RoboFEI/Eletronics/Communication_Board/Communication_Board/Communication_Board.kicad_pcb

## KiCad design Communication_Board/Communication_Board/Communication_Board.kicad_pcb (2024-09-18)

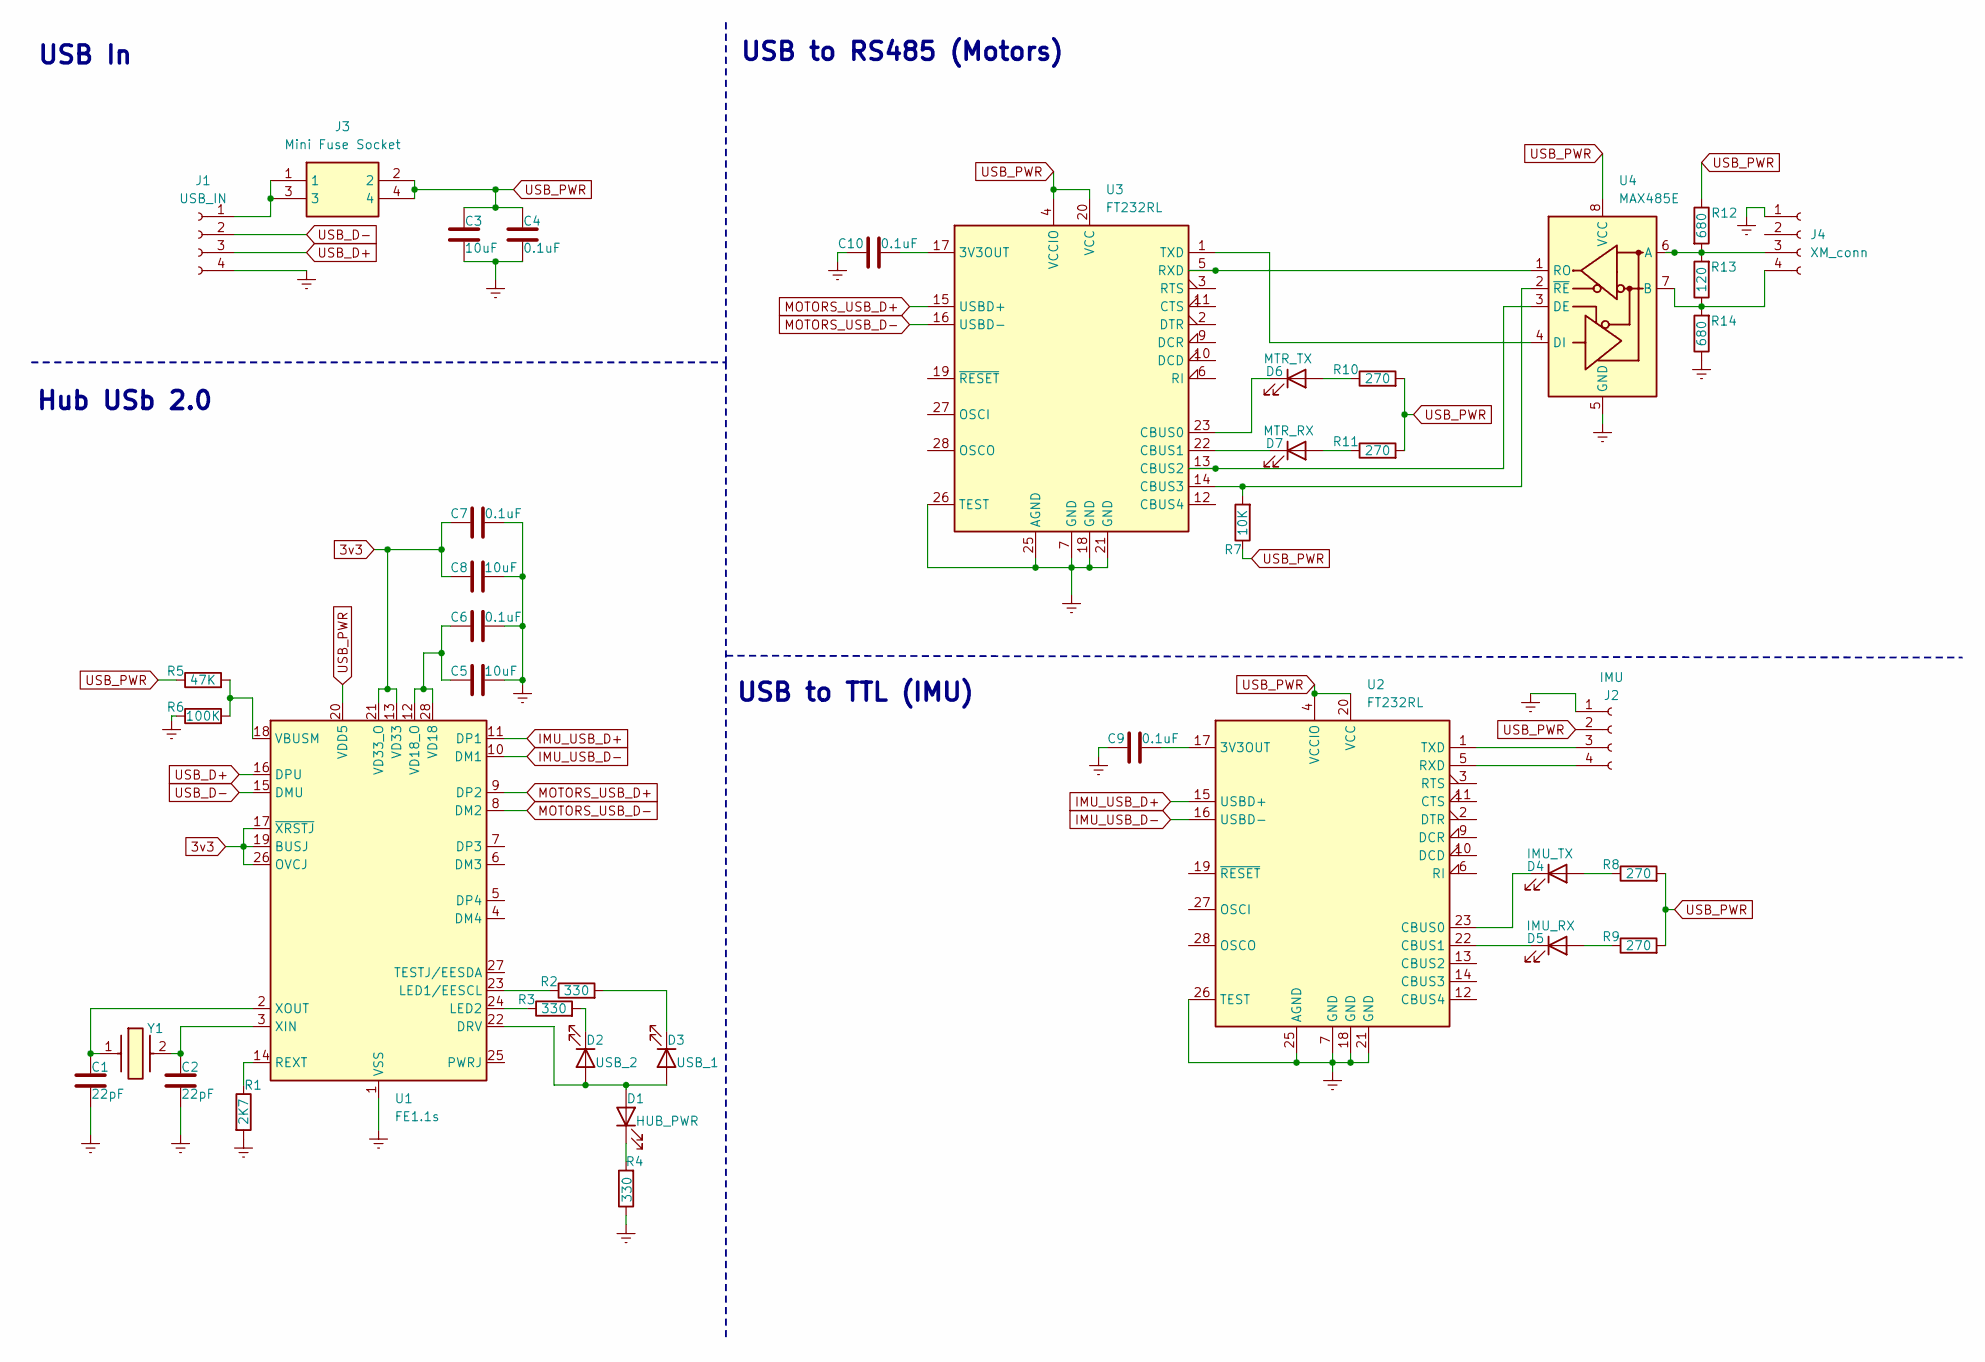
[picture p1: schematic Communication_Board.kicad_sch, Communication Board for Humanoid Robot]

Parts:
C1, C2: 22pF; C_1206_3216Metric
C3, C5, C8: 10uF; C_1206_3216Metric
C4, C6, C7, C9, C10: 0.1uF; C_1206_3216Metric
D1: HUB_PWR; LED_1206_3216Metric_Pad1.42x1.75mm_HandSolder
D2: USB_2; LED_1206_3216Metric_Pad1.42x1.75mm_HandSolder
D3: USB_1; LED_1206_3216Metric_Pad1.42x1.75mm_HandSolder
D4: IMU_TX; LED_1206_3216Metric_Pad1.42x1.75mm_HandSolder
D5: IMU_RX; LED_1206_3216Metric_Pad1.42x1.75mm_HandSolder
D6: MTR_TX; LED_1206_3216Metric_Pad1.42x1.75mm_HandSolder
D7: MTR_RX; LED_1206_3216Metric_Pad1.42x1.75mm_HandSolder
J1: USB_IN; PinHeader_1x04_P2.54mm_Vertical
J2: IMU; PinHeader_1x04_P2.54mm_Vertical
J3: Mini Fuse Socket; Mouser Part Number 534-3557-2
J4: XM_conn; XM_conn_vertical-B4B-EH-A
R1: 2K7; R_1206_3216Metric
R2, R3, R4: 330; R_1206_3216Metric
R5: 47K; R_1206_3216Metric
R6: 100K; R_1206_3216Metric
R7: 10K; R_1206_3216Metric
R8, R9, R10, R11: 270; R_1206_3216Metric
R12, R14: 680; R_1206_3216Metric
R13: 120; R_1206_3216Metric
U1: FE1.1s; SSOP-28_3.9x9.9mm_P0.635mm
U2, U3: FT232RL; SSOP-28_5.3x10.2mm_P0.65mm
U4: MAX485E; SOIC-8_3.9x4.9mm_P1.27mm
Y1: Crystal 12MHz - ECS; Mouser Part Number 520-120-18-5PX-GM-TR

Connections:
3v3: C7.1, C8.1, U1.13 (VD33), U1.17 (~XRSTJ), U1.19 (BUSJ), U1.21 (VD33_O), U1.26 (OVCJ)
GNDREF: C1.2, C2.2, C3.2, C4.2, C5.2, C6.2, C7.2, C8.2, C9.1, C10.1, J1.4, J2.1, J4.1 (GND), R1.2, R4.1, R6.1, R14.1, U1.1 (VSS), U2.7 (GND), U2.18 (GND), U2.21 (GND), U2.25 (AGND), U2.26 (TEST), U3.7 (GND), U3.18 (GND), U3.21 (GND), U3.25 (AGND), U3.26 (TEST), U4.5 (GND)
IMU_USB_D+: U1.11 (DP1), U2.15 (USBD+)
IMU_USB_D-: U1.10 (DM1), U2.16 (USBD-)
MOTORS_USB_D+: U1.9 (DP2), U3.15 (USBD+)
MOTORS_USB_D-: U1.8 (DM2), U3.16 (USBD-)
unnamed: D1.2 (A), D2.2 (A), D3.2 (A), U1.22 (DRV)
unnamed: D1.1 (K), R4.2
unnamed: D2.1 (K), R3.2
unnamed: D3.1 (K), R2.2
unnamed: D4.2 (A), R8.1
unnamed: D4.1 (K), U2.23 (CBUS0)
unnamed: D5.2 (A), R9.1
unnamed: D5.1 (K), U2.22 (CBUS1)
unnamed: D6.2 (A), R10.1
unnamed: D6.1 (K), U3.23 (CBUS0)
unnamed: D7.2 (A), R11.1
unnamed: D7.1 (K), U3.22 (CBUS1)
unnamed: J1.1, J3.1, J3.3
unnamed: J2.3, U2.1 (TXD)
unnamed: J2.4, U2.5 (RXD)
unnamed: J4.3 (D+), R12.2, R13.2, U4.6 (A)
unnamed: J4.4 (D-), R13.1, R14.2, U4.7 (B)
unnamed: R2.1, U1.23 (LED1/EESCL)
unnamed: R3.1, U1.24 (LED2)
unnamed: R1.1, U1.14 (REXT)
unnamed: R5.2, R6.2, U1.18 (VBUSM)
unnamed: C5.1, C6.1, U1.12 (VD18_O), U1.28 (VD18)
unnamed: C2.1, U1.3 (XIN), Y1.2
unnamed: C1.1, U1.2 (XOUT), Y1.1
unnamed: C9.2, U2.17 (3V3OUT)
unnamed: C10.2, U3.17 (3V3OUT)
unnamed: U3.13 (CBUS2), U4.3 (DE)
unnamed: R7.2, U3.14 (CBUS3), U4.2 (~RE)
unnamed: U3.5 (RXD), U4.1 (RO)
unnamed: U3.1 (TXD), U4.4 (DI)
USB_D+: J1.3, U1.16 (DPU)
USB_D-: J1.2, U1.15 (DMU)
USB_PWR: C3.1, C4.1, J2.2, J3.2, J3.4, R5.1, R7.1, R8.2, R9.2, R10.2, R11.2, R12.1, U1.20 (VDD5), U2.4 (VCCIO), U2.20 (VCC), U3.4 (VCCIO), U3.20 (VCC), U4.8 (VCC)

Notes on the sheet:
USB In
USB to RS485 (Motors)
Hub USb 2.0
USB to TTL (IMU)

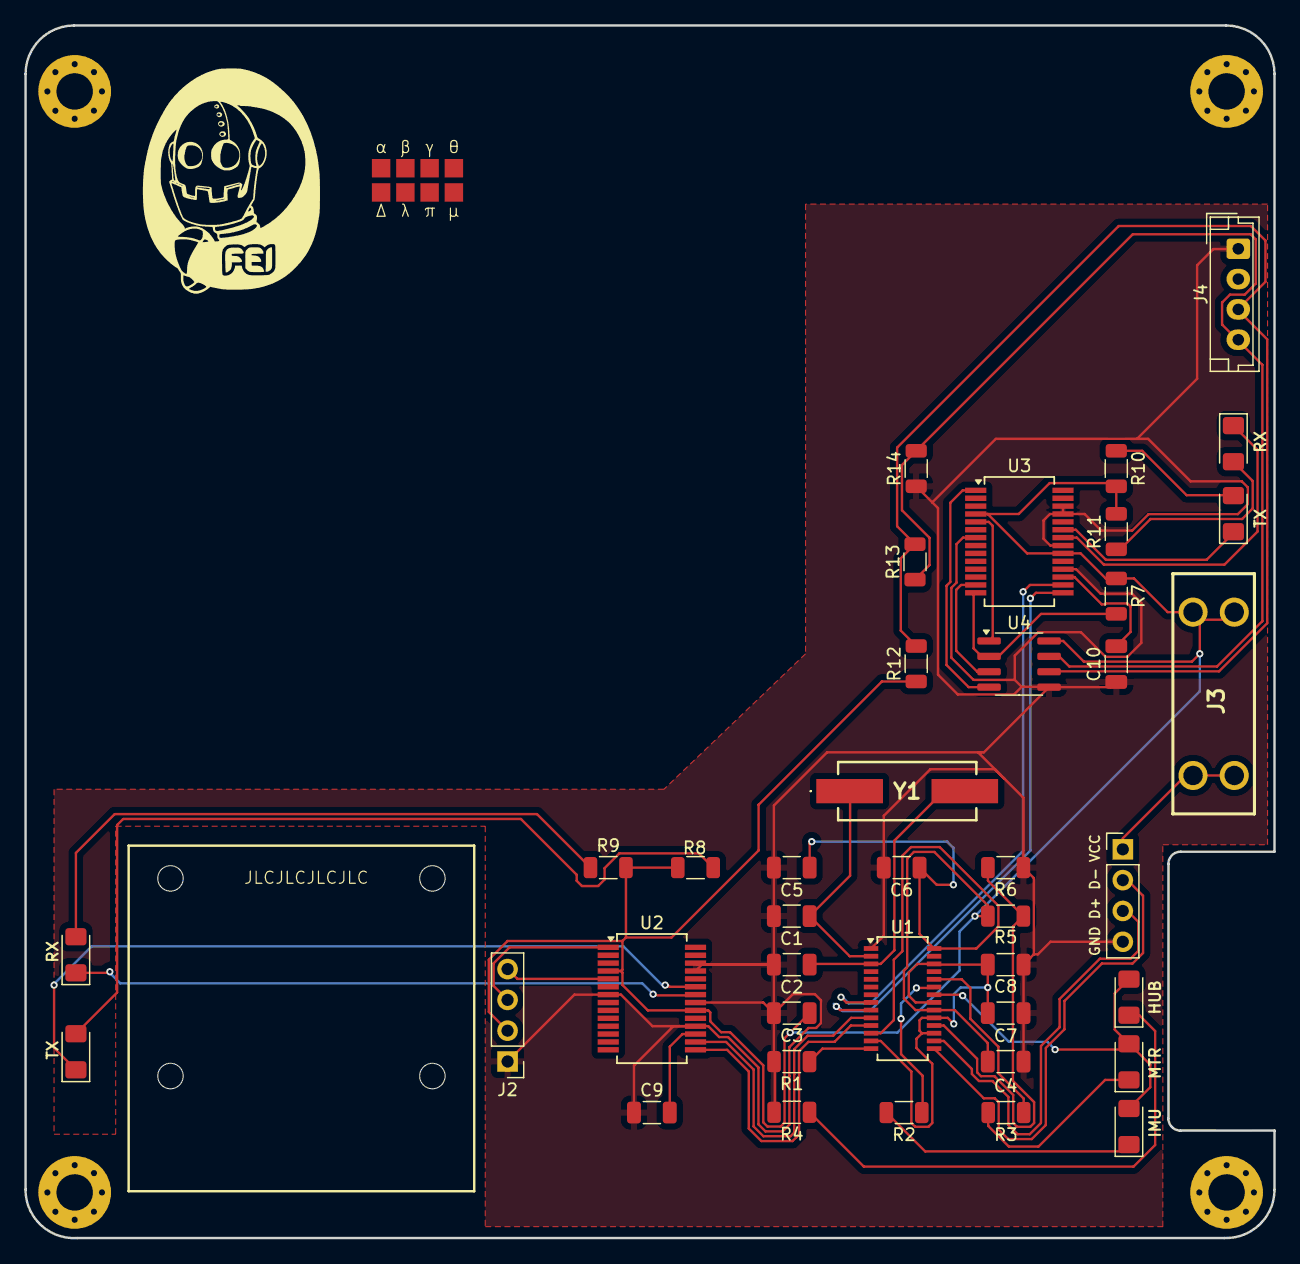
[picture p2: board Communication_Board.kicad_pcb from above]

Board: 2 copper layers, 103.0 x 100.0 mm, 40 parts (0 on the bottom side), 39 nets.
