RoboFEI/Eletronics/Power_Board/Power_Board/Power_Board.kicad_pcb

## KiCad design Power_Board/Power_Board/Power_Board.kicad_pcb (2024-09-28)

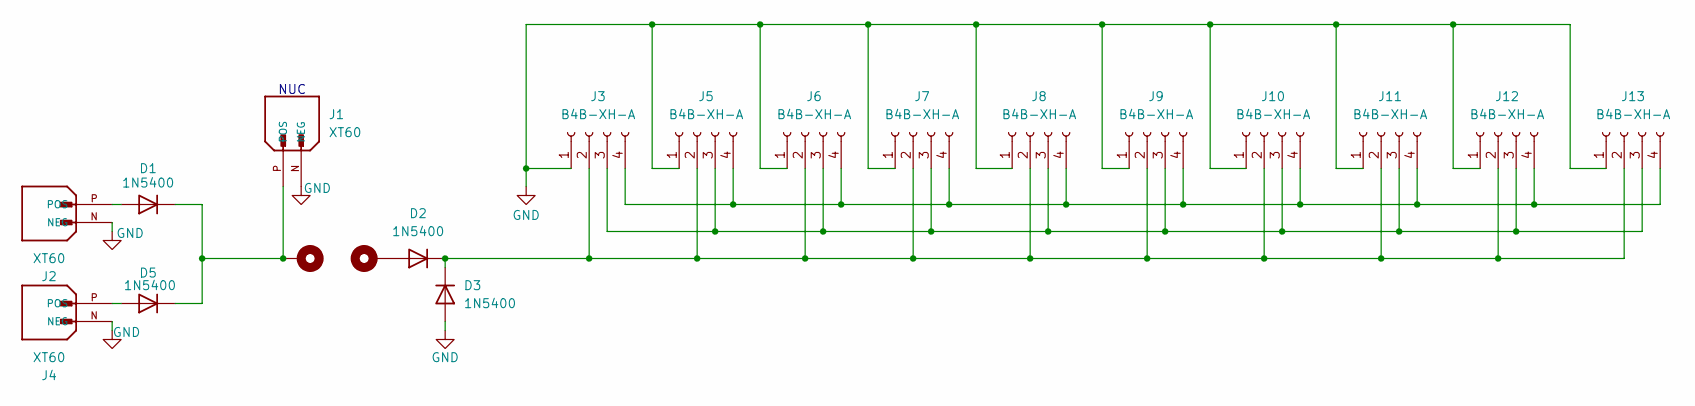
[picture p3: schematic Power_Board.kicad_sch]

Parts:
D1, D2, D3, D5: 1N5400; D_DO-201AD_P15.24mm_Horizontal
H1, H3: MountingHole_Pad; MountingHole_2.5mm_Pad
J1, J2, J4: XT60; XT60-M_Vertical; PARTREV V1.2
J3, J5, J6, J7, J8, J9, J10, J11, J12, J13: B4B-XH-A; XM_conn_vertical-B4B-EH-A; PARTREV 7/4/21

Connections:
GND: D3.2 (A), J1.N (NEG), J2.N (NEG), J3.1 (GND), J4.N (NEG), J5.1 (GND), J6.1 (GND), J7.1 (GND), J8.1 (GND), J9.1 (GND), J10.1 (GND), J11.1 (GND), J12.1 (GND), J13.1 (GND)
unnamed: D1.2 (A), J2.P (POS)
unnamed: D1.1 (K), D5.1 (K), H3.1, J1.P (POS)
unnamed: D2.2 (A), H1.1
unnamed: D2.1 (K), D3.1 (K), J3.2 (VDD), J5.2 (VDD), J6.2 (VDD), J7.2 (VDD), J8.2 (VDD), J9.2 (VDD), J10.2 (VDD), J11.2 (VDD), J12.2 (VDD), J13.2 (VDD)
unnamed: D5.2 (A), J4.P (POS)
unnamed: J3.3 (D+), J5.3 (D+), J6.3 (D+), J7.3 (D+), J8.3 (D+), J9.3 (D+), J10.3 (D+), J11.3 (D+), J12.3 (D+), J13.3 (D+)
unnamed: J3.4 (D-), J5.4 (D-), J6.4 (D-), J7.4 (D-), J8.4 (D-), J9.4 (D-), J10.4 (D-), J11.4 (D-), J12.4 (D-), J13.4 (D-)

Notes on the sheet:
NUC

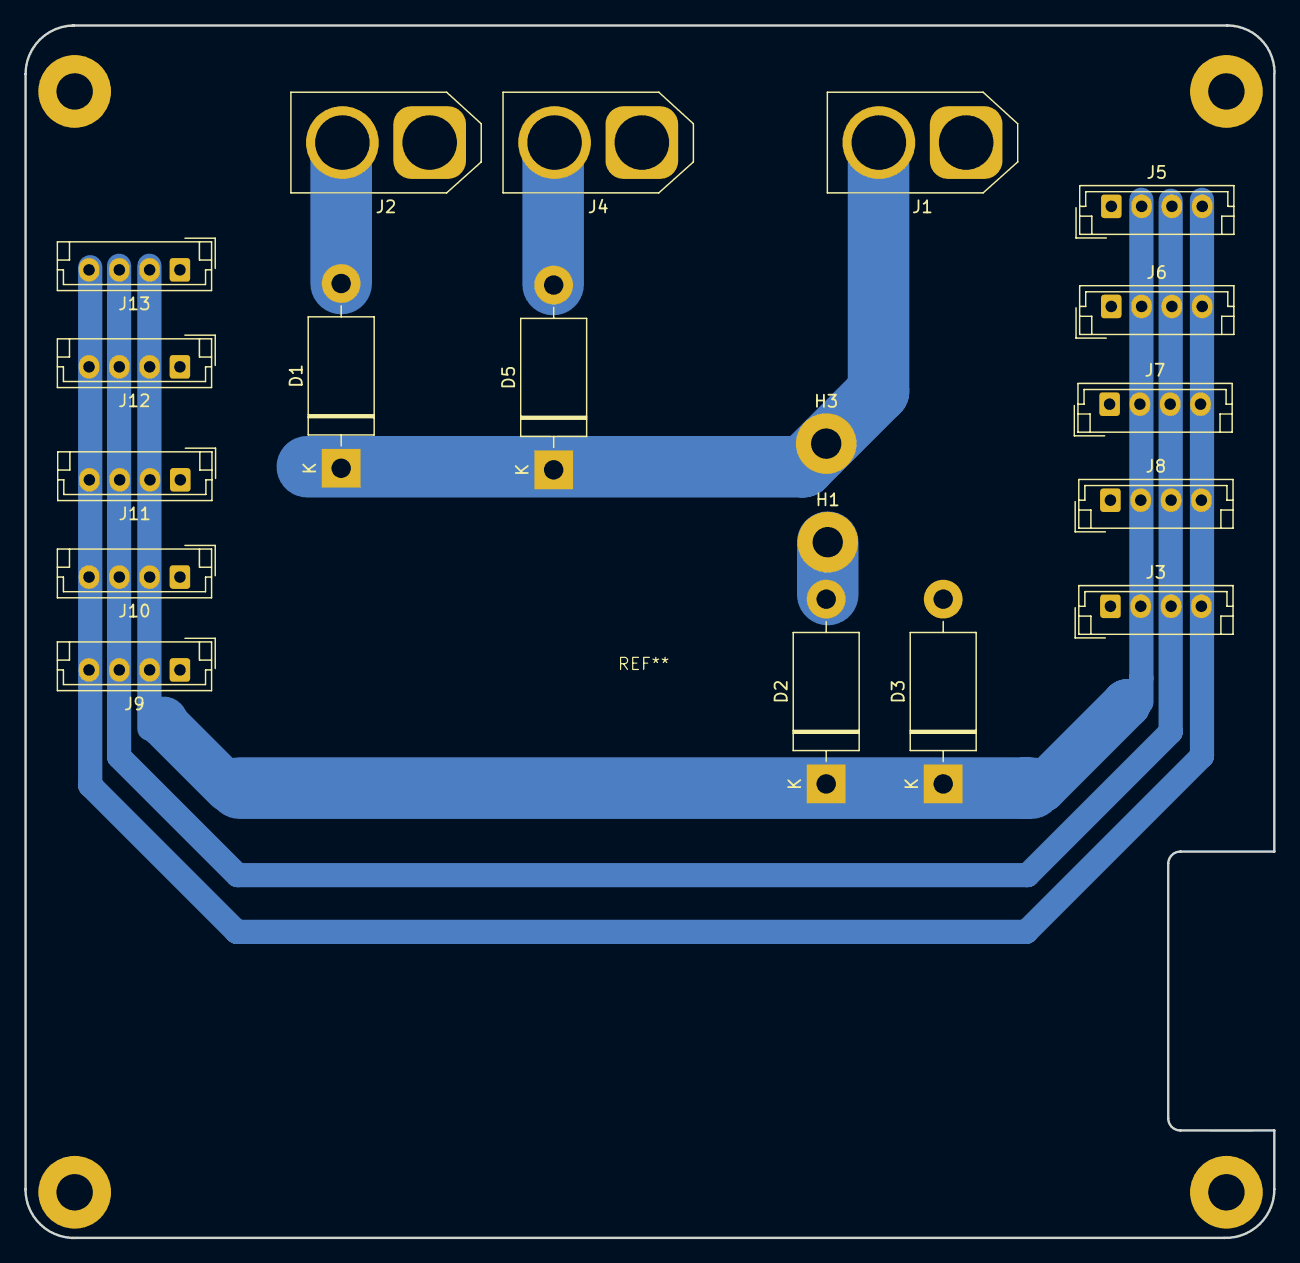
[picture p4: board Power_Board.kicad_pcb from above]

Board: 2 copper layers, 103.0 x 100.0 mm, 19 parts (0 on the bottom side), 8 nets.
