RoboFEI/Eletronics/(commit log)

2024-09-18 Communication board v1.0
    [communication_board.kicad_pcb, communication_board.kicad_sch]
2024-09-18 Organizing Comm board folder
    [communication_board.kicad_pcb, communication_board.kicad_sch]
2024-09-19 add bom list
2024-09-28 update Libraries and Power Board
    [Power_Board.kicad_pcb, Power_Board.kicad_sch]
2024-10-29 Add inicio de placa de potencia para testes
    [Power_Board_For_Tests.kicad_pcb, Power_Board_For_Tests.kicad_sch]
2024-11-05 Update setup.sh for more be more practice and rename comm_board for Communication_Board
    [Communication_Board.kicad_pcb, Communication_Board.kicad_sch]
